SethNeumann/MRCS-MorseKOB-Sounder-Driver/README.md

# REPO NAME: MRCS-MorseKOB-Sounder-Driver
## License: Creative Commons Attribution-NonCommercial-ShareAlike

A simple interface board to drive a vintage telegraph sounder from an RS232 Dongle for the popular MorseKOB program
