SethNeumann/MRCS-MorseKOB-Sounder-Driver/MRCS-MorseKOB_Sounder_Driver.brd

## EAGLE design MRCS-MorseKOB_Sounder_Driver.brd (2024-06-01)

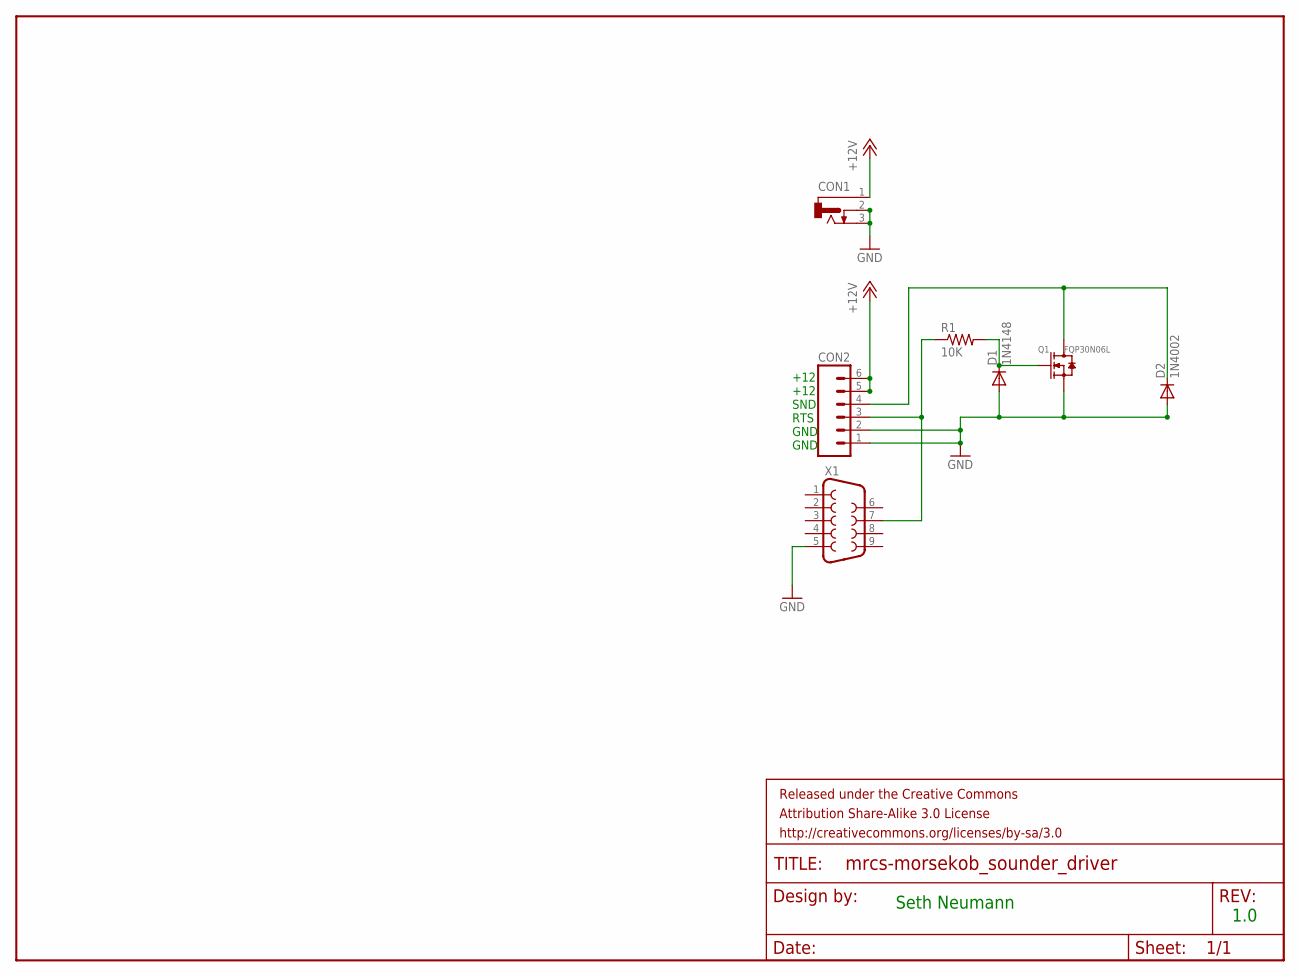
[picture p1: schematic MRCS-MorseKOB_Sounder_Driver.sch]

Parts:
CON1: CONNECTOR-DC-POWER-RA; DCJ0202
CON2: CONNECTOR-M063.5MM-6; SCREWTERMINAL-3.5MM-6
D1: 1N4148; DIODE-1N4148
D2: 1N4002; DIODE-1N4001
FRAME1: FRAME-LETTER; CREATIVE_COMMONS
Q1: FQP30N06L; TO220V
R1: 10K; AXIAL-0.4-RES
X1: DB9FEMALE; DB9

Connections:
+12V: CON1.1, CON2.5, CON2.6
GND: CON1.2, CON1.3, CON2.1, CON2.2, D1.A, D2.A, Q1.3 (S), X1.5
unnamed: CON2.3, R1.P$1 (1), X1.7
unnamed: D1.C, Q1.1 (G), R1.P$2 (2)
unnamed: CON2.4, D2.C, Q1.2 (D)

Notes on the sheet:
+12 +12 SND RTS GND GND
Seth Neumann
1.0

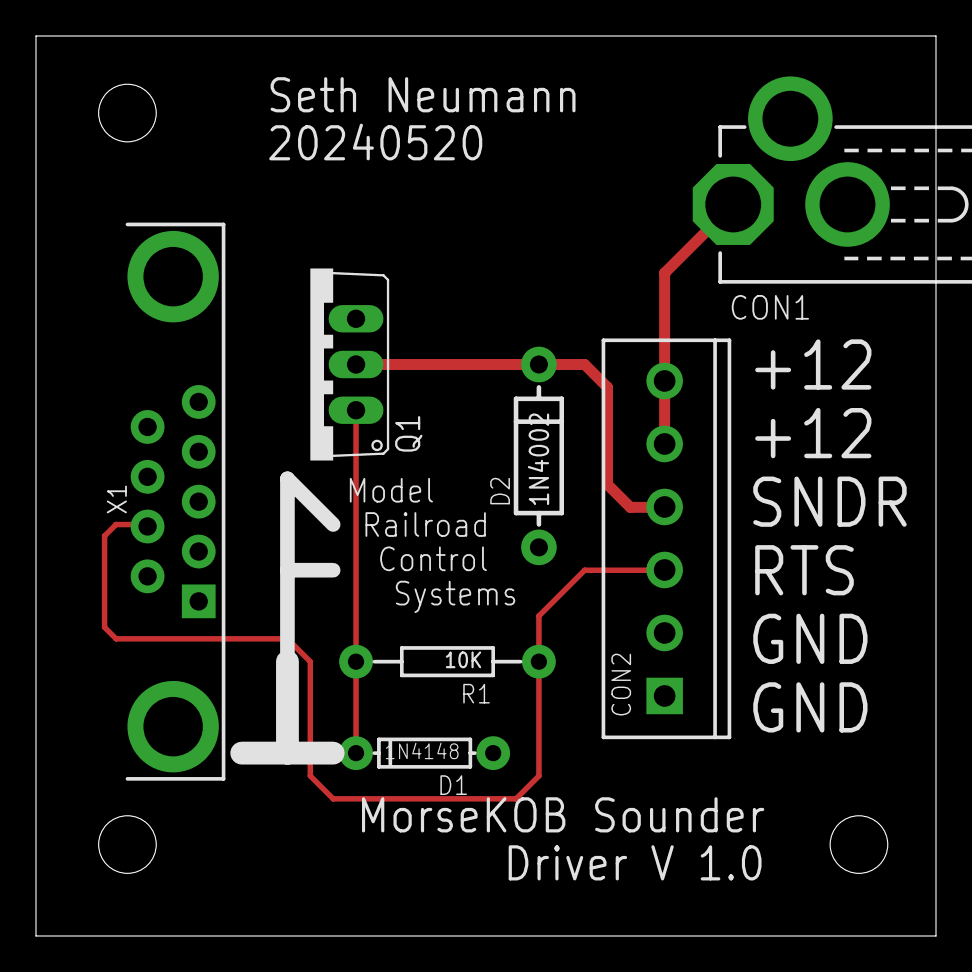
[picture p2: board MRCS-MorseKOB_Sounder_Driver.brd from above]

Board: 2 copper layers, 50.0 x 50.0 mm, 10 parts (0 on the bottom side), 5 nets.

Other parts of the board:
U$1: MRCS-LOGO
U$2: CA-PROP65WARNING
