SethNeumann/MRCS-MorseKOB-Sounder-Driver/(commit log)

2024-06-01 migrated off line files into repository
    Moved work done off line including some documentation into the repo. Initial design was successful. Not surprising as I used the schematic in the excellent MorseKOB documentation.
    [EagleTemplate-new.brd, EagleTemplate-new.sch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]
2024-06-03 finished Version 1.0 documentation
    [MRCS-MorseKOB_Sounder_Driver.csv, Morse_KOB_Sounder_driver_BOM.xlsx]
